dinhdatthong1809/propeller-led/IMAGES/PROPELLER LED 3D PCB (FRONT 3).png

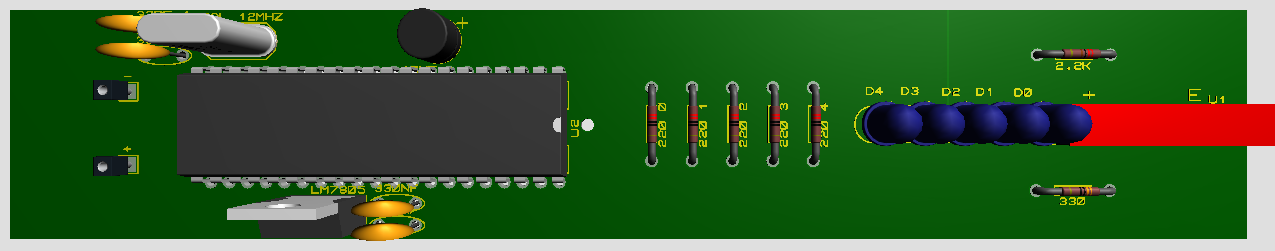
IMAGES/PROPELLER LED 3D PCB (FRONT 3).png
