dinhdatthong1809/propeller-led/README.md

# PropellerLED
View the doc here:
https://github.com/dinhdatthong1809/PropellerLED/blob/master/REPORT/PROPELLER%20LED%20REPORT.pdf
