dinhdatthong1809/propeller-led/SLIDE/PROPELLER LED SLIDE.pptx

BÁO CÁO ĐỒ ÁN

LED QUAY

ĐINH ĐẠT THÔNG - 15520853

## Slide 2

GIỚI THIỆU

LED QUAY LÀ GÌ?


## Slide 3

SƠ ĐỒ KHỐI PHẦN CỨNG

VI ĐIỀU KHIỂN

AT89C51

CÁC LED HIỂN THỊ

NGUỒN 12V MỘT CHIỀU

MÔ TƠ DC

MẠCH NGẮT

## Slide 4

SƠ ĐỒ MẠCH ĐIỆN

## Slide 5

SƠ ĐỒ MẠCH IN

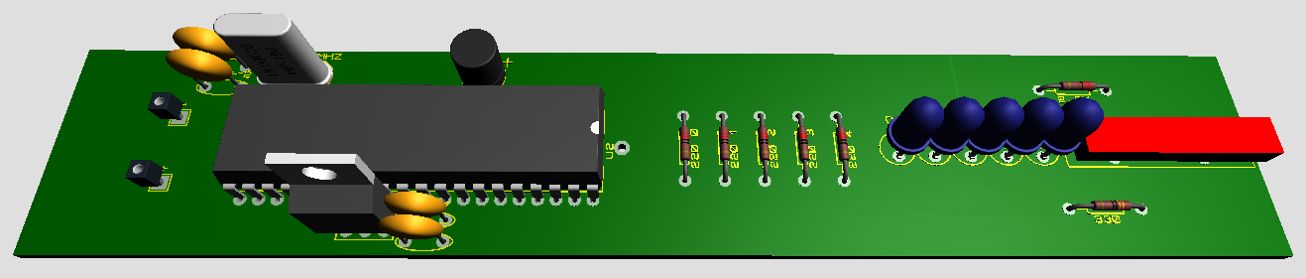
[picture p31: figure]
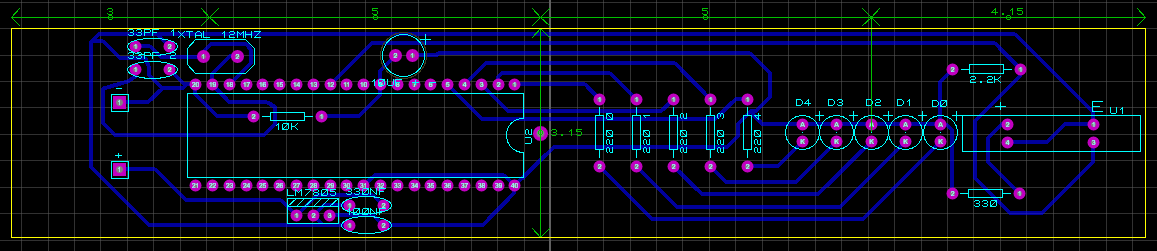
[picture p32: figure]

## Slide 6

SƠ ĐỒ GIẢI QUYẾT BÀI TOÁN

BẮT ĐẦU

LỰA CHỌN MOTOR CÓ TỐC ĐỘ QUAY HƠN 25 VÒNG/GIÂY

TÍNH THỜI GIAN MOTOR QUAY 1 VÒNG

TÍNH THỜI GIAN HIỂN THỊ CỦA MỘT CỘT

TÍNH GIÁ TRỊ HÀM DELAY ĐỂ LED CHỚP TẮT TẠO HÌNH ẢNH

HOÀN TẤT

TIẾN HÀNH VIẾT VÀ NẠP CHƯƠNG TRÌNH CHO 8051

THIẾT KẾ PHẦN CỨNG

## Slide 7

SƠ ĐỒ GIẢI THUẬT CHƯƠNG TRÌNH

BẮT ĐẦU

KHI NGẮT NGOÀI XẢY RA

KHỞI ĐỘNG CÁC CHỨC NĂNG TIMER, NGẮT NGOÀI

CHO CON TRỎ CHỈ ĐẾN BYTE KẾ TIẾP CẦN XUẤT

TẠO MẢNG DỮ LIỆU LƯU TRONG ROM, CON TRỎ CHỈ ĐẾN Ô NHỚ TRƯỚC Ô NHỚ CHỨA BYTE ĐẦU TIÊN CẦN XUẤT

XUẤT 1 BYTE TRONG MẢNG DỮ LIỆU RA PORT

GỌI HÀM DELAY

CHỜ NGẮT NGOÀI XẢY RA

0

XUẤT HẾT DỮ LIỆU

THOÁT HÀM NGẮT

1

## Slide 8

KẾT THÚC

CẢM ƠN MỌI NGƯỜI ĐÃ THEO DÕI
