dinhdatthong1809/propeller-led/IMAGES/PROPELLER LED 2D IMAGES.png

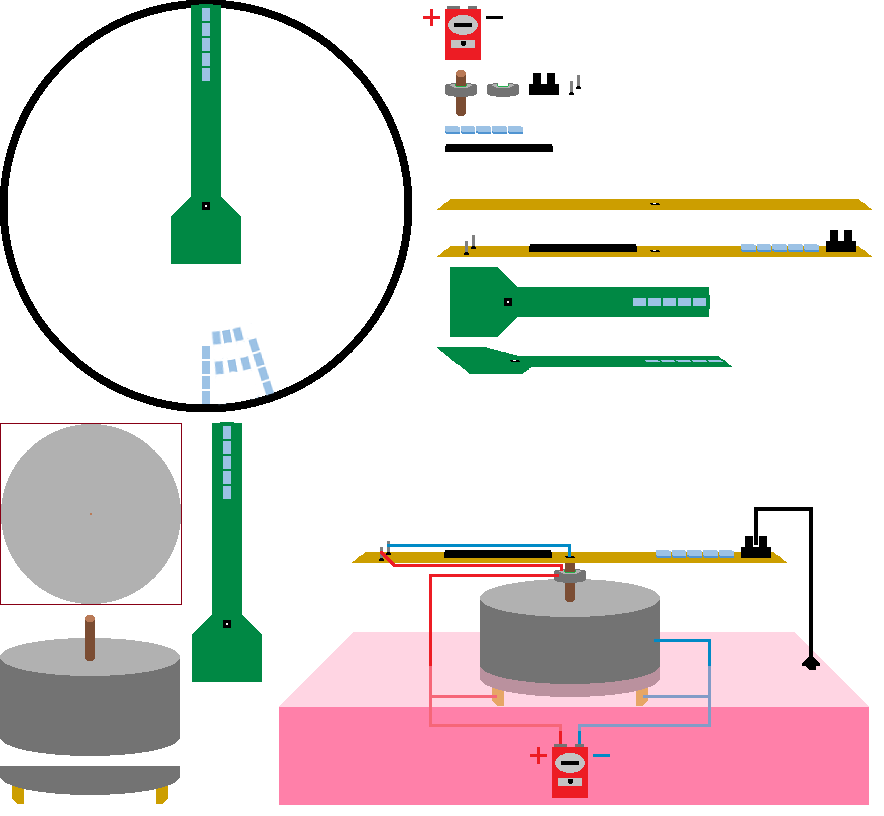
IMAGES/PROPELLER LED 2D IMAGES.png
