dinhdatthong1809/propeller-led/SCHEMATIC AND PCB/PROPELLER LED.PDF

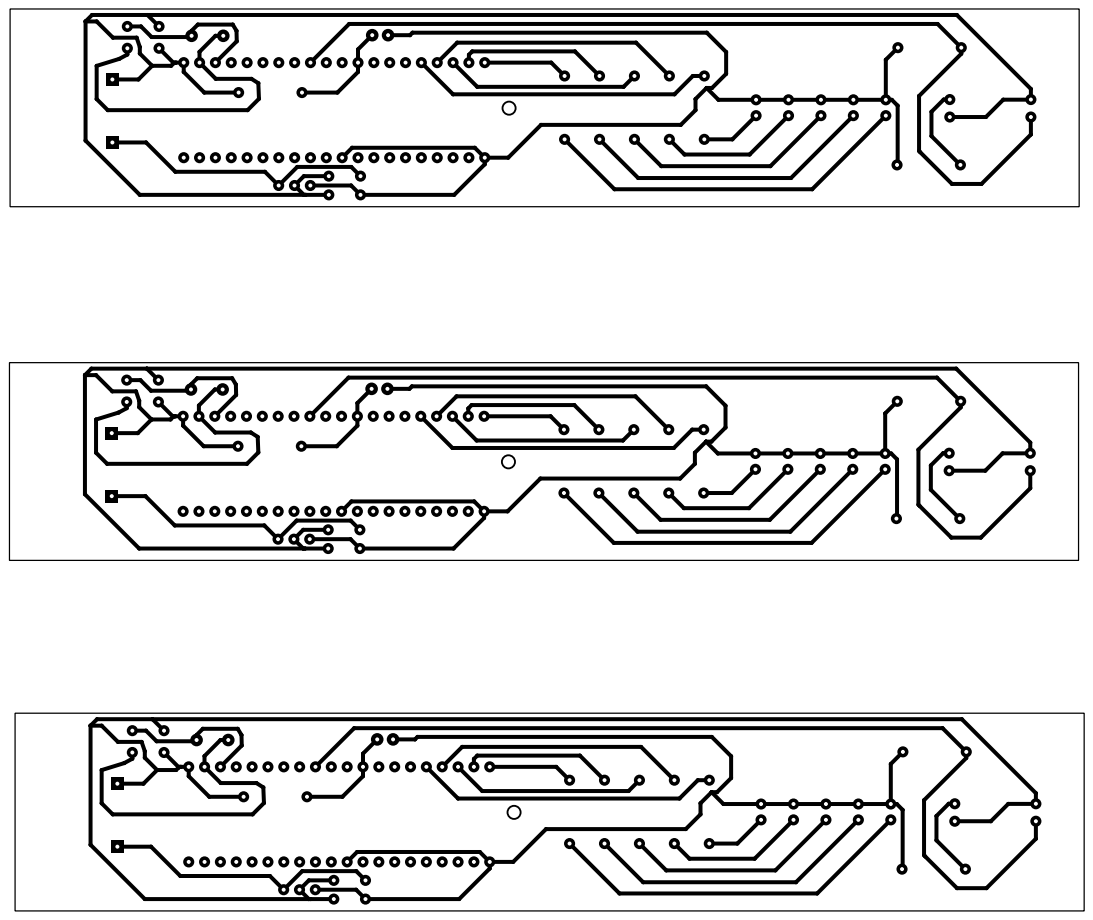
[picture p34: page 1]
