dinhdatthong1809/propeller-led/(list of files, drawings)

Other design files:
SCHEMATIC AND PCB/PROPELLER LED.pdsprj
